mmiller7/Arduino-Velocity-Speed-Gun/Diagrams/Modification Schematic.pptx

Schematic

3.3V
Regulator

OUT

GND

Trigger Board

Battery+

Battery Ground

IN

470uF

CUT
TRACE

+5V USB Input

USB Ground

USB Data

10Ω

Trigger

V+ Out

10Ω

5V
Relay

5V Boost
Regulator

OUT

GND

IN

100uF

1kΩ

1kΩ

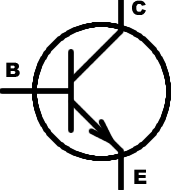
[picture p6: figure]

NPN

470uF

Arduino Micro
(or Leonardo, or ATmega32u4)

Radar Gun Control Board

5v

D7
(USB Pwr Detect)

D2
(Trigger)

GND

USB DATA

(Pwr On)
D3

(Pwr Off)
A11
D12

Trace

(LCD Data)
A0 - A10

LCD Pins

R1

## Slide 2

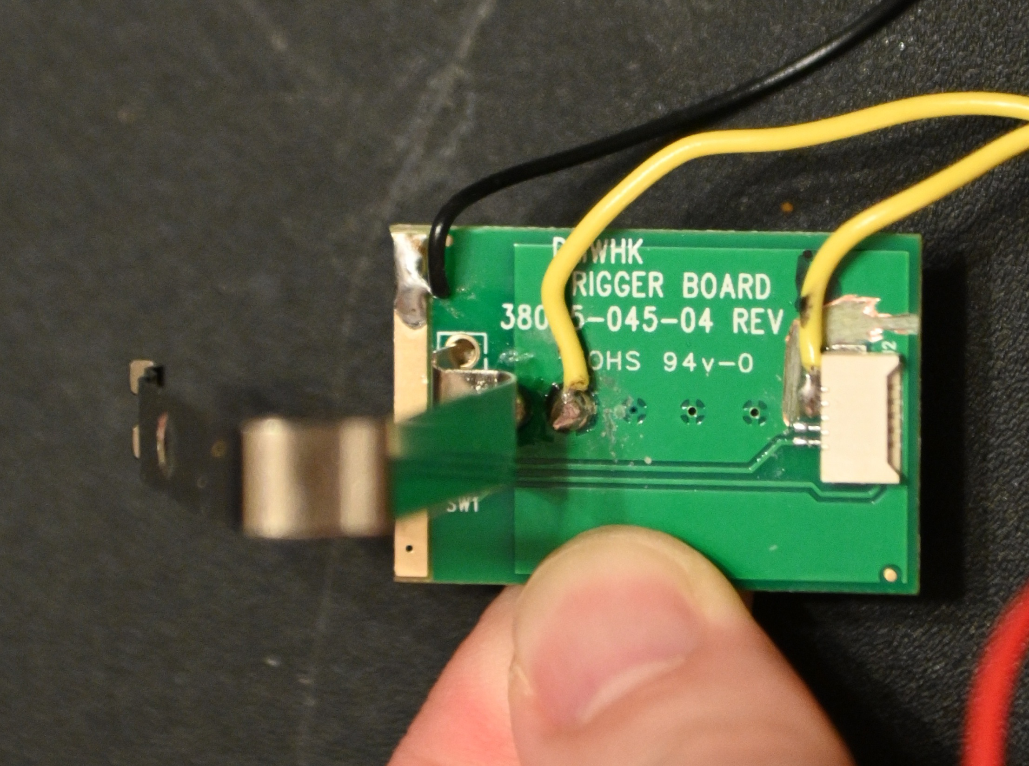
[picture p7: figure]

Trigger Board “Rev B” Modification Diagram

Trigger
Control

L-shaped
Cut Trace
separate
Battery +
from
board V+

Board
Positive

Top 3 Pins
all tied
together

Do Not Cut
bottom 2
traces

Battery
Positive

L-shaped
Cut Trace
separate
Battery +
from
board V+

## Slide 3

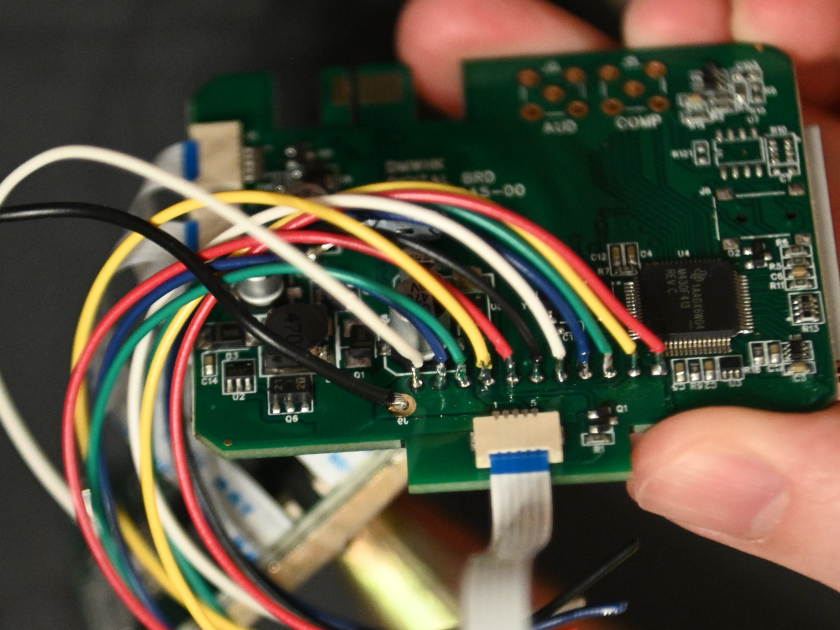
[picture p8: figure]

Main Board Modification Wiring

--A10
--A9
--A8
--A7
--A6
--A5
--A4
--A3
--A2
--A1
--A0

PWR
OFF

PWR
ON

## Slide 4

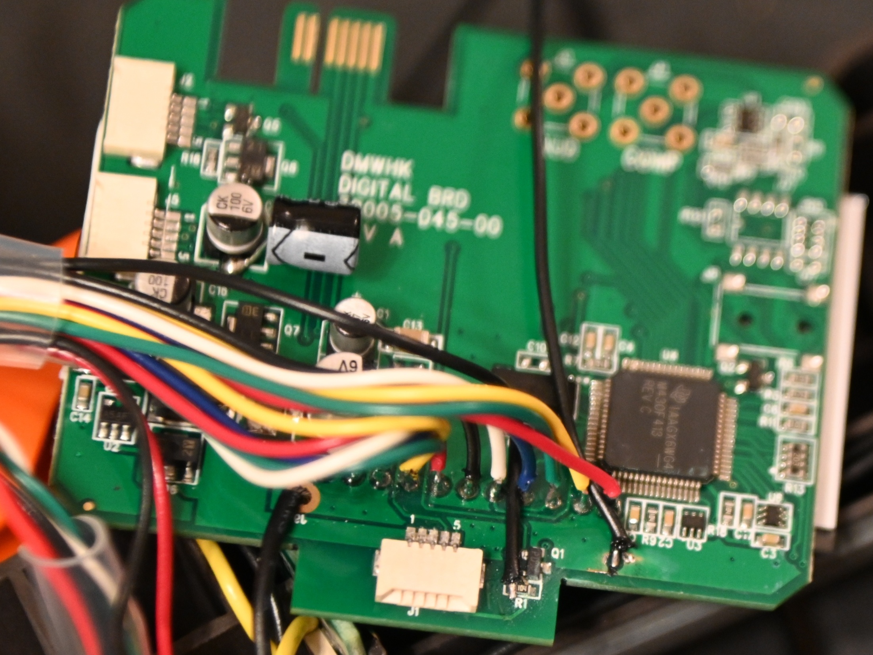
[picture p9: figure]

Main Board Modification Wiring

--A10
--A9
--A8
--A7
--A6
--A5
--A4
--A3
--A2
--A1
--A0

PWR ON

PWR
OFF

## Slide 5

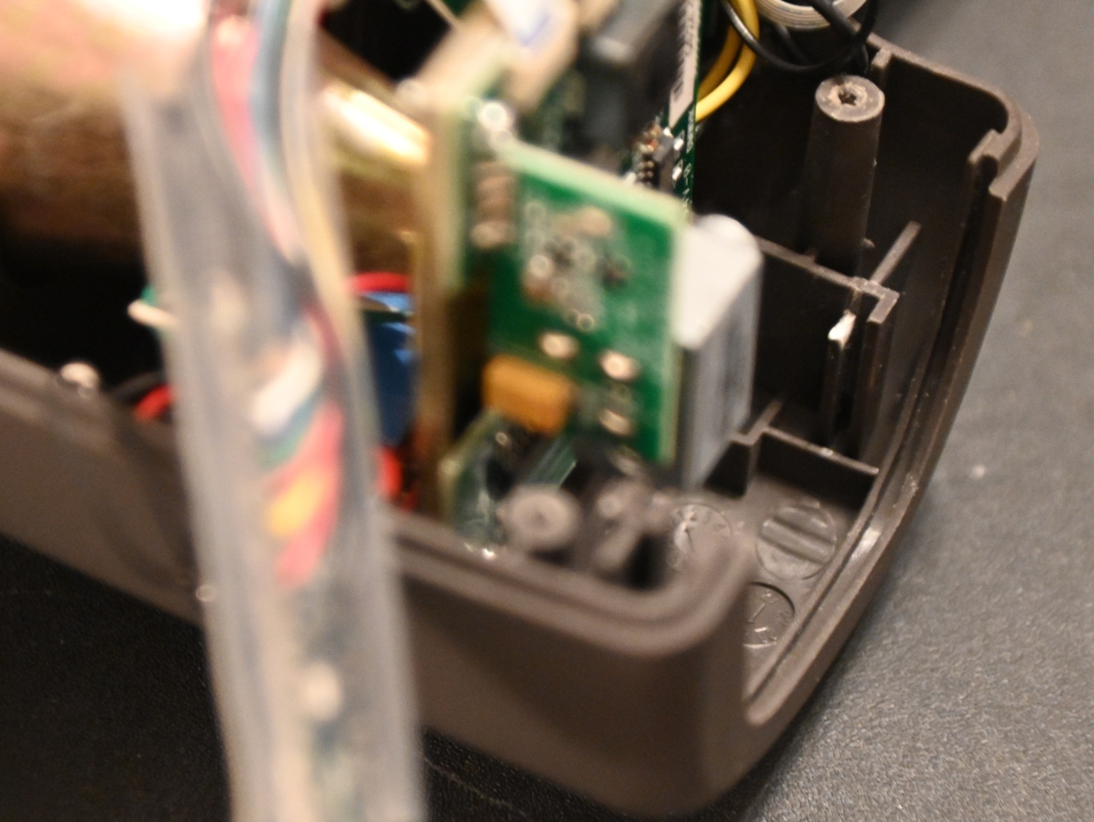
[picture p10: figure]

Case Modification

Cut/Remove
rear guide
1/4 to 3/8 inch
This portion of the
guide will damage
the trace for the
power-off wire
when board installed
