mmiller7/Arduino-Velocity-Speed-Gun/Photos/DSC_7530.JPG

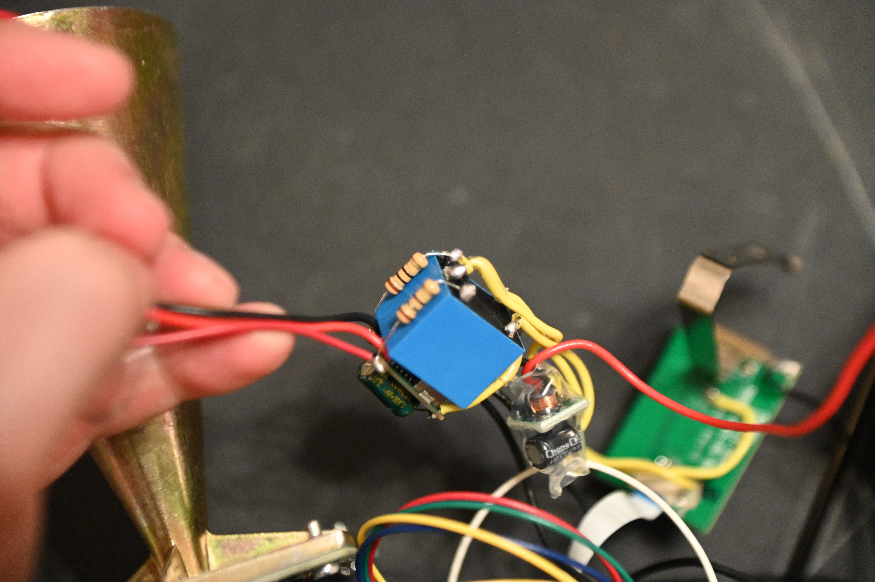
Photos/DSC_7530.JPG
