mmiller7/Arduino-Velocity-Speed-Gun/Photos/DSC_7531.JPG

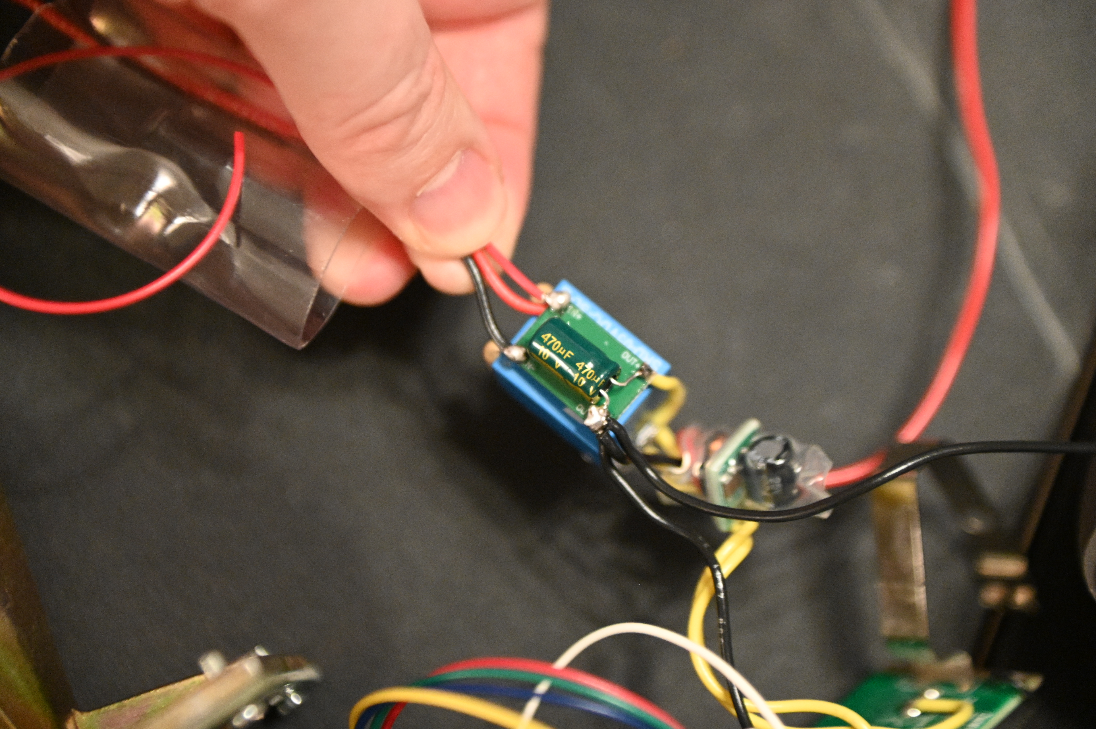
Photos/DSC_7531.JPG
