mmiller7/Arduino-Velocity-Speed-Gun/Photos/DSC_7532.JPG

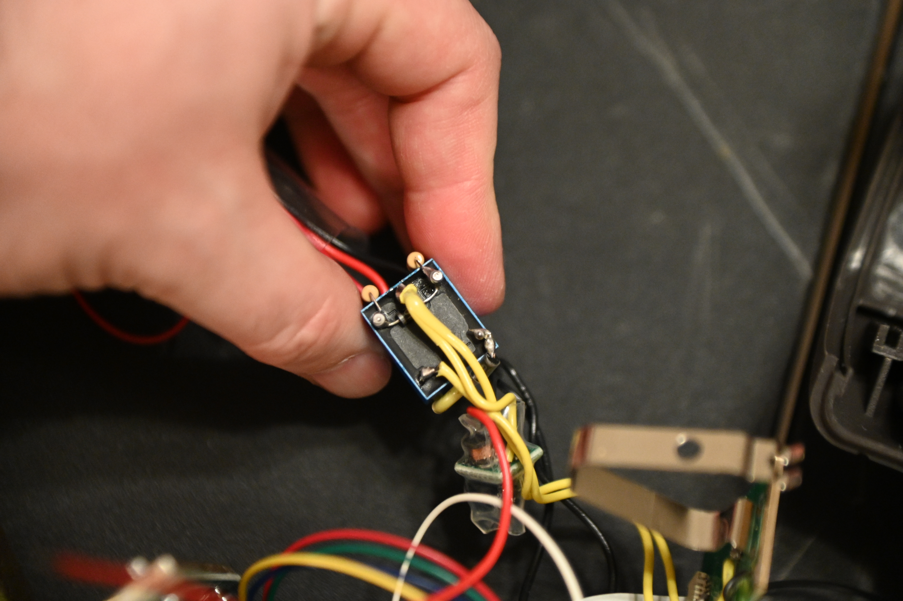
Photos/DSC_7532.JPG
