mmiller7/Arduino-Velocity-Speed-Gun/Photos/DSC_7533.JPG

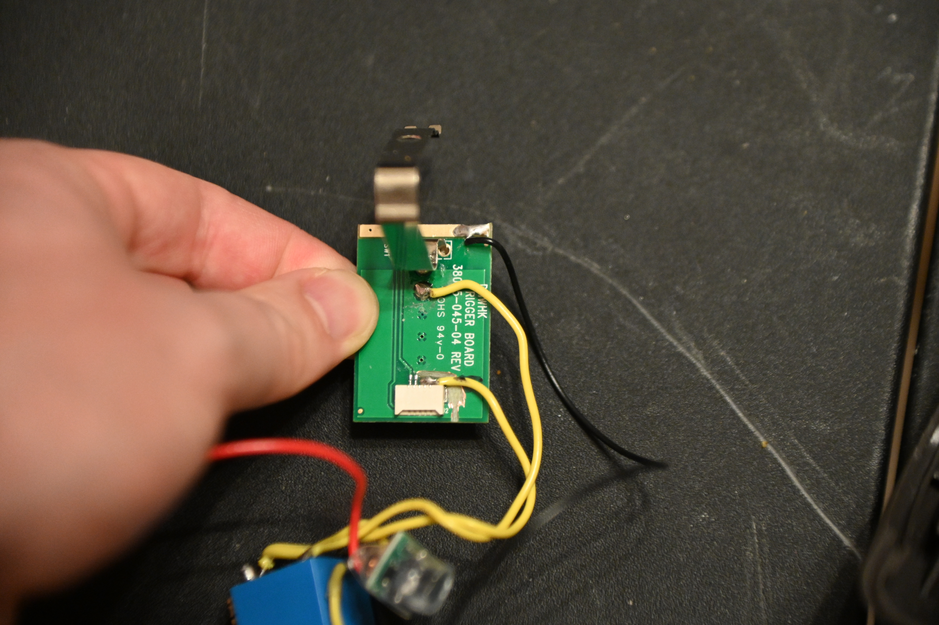
Photos/DSC_7533.JPG
