mmiller7/Arduino-Velocity-Speed-Gun/Photos/DSC_7534.JPG

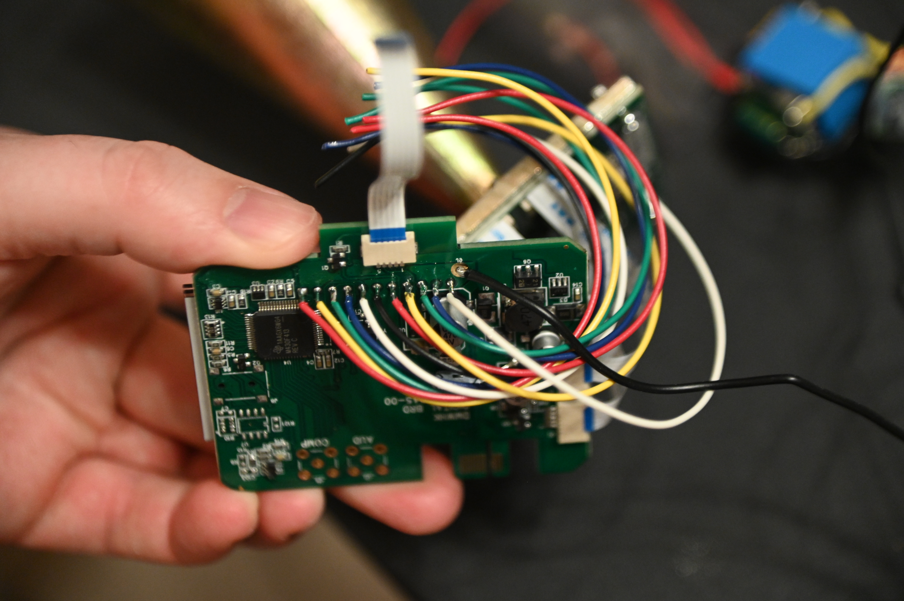
Photos/DSC_7534.JPG
