mmiller7/Arduino-Velocity-Speed-Gun/Photos/DSC_7535.JPG

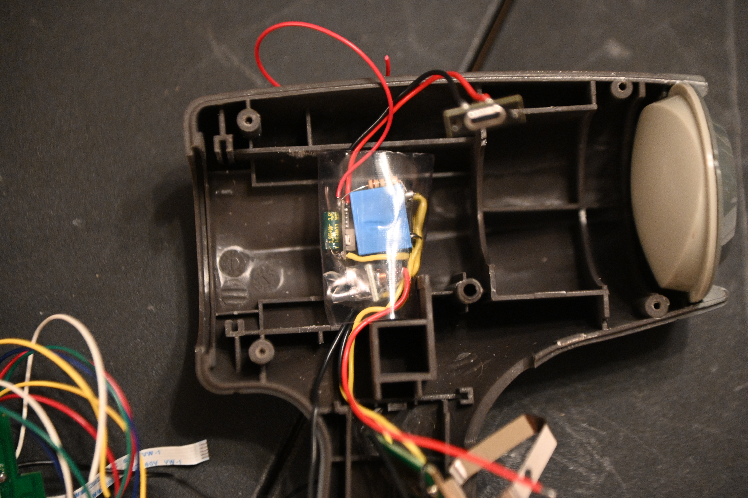
Photos/DSC_7535.JPG
