mmiller7/Arduino-Velocity-Speed-Gun/Photos/DSC_7537.JPG

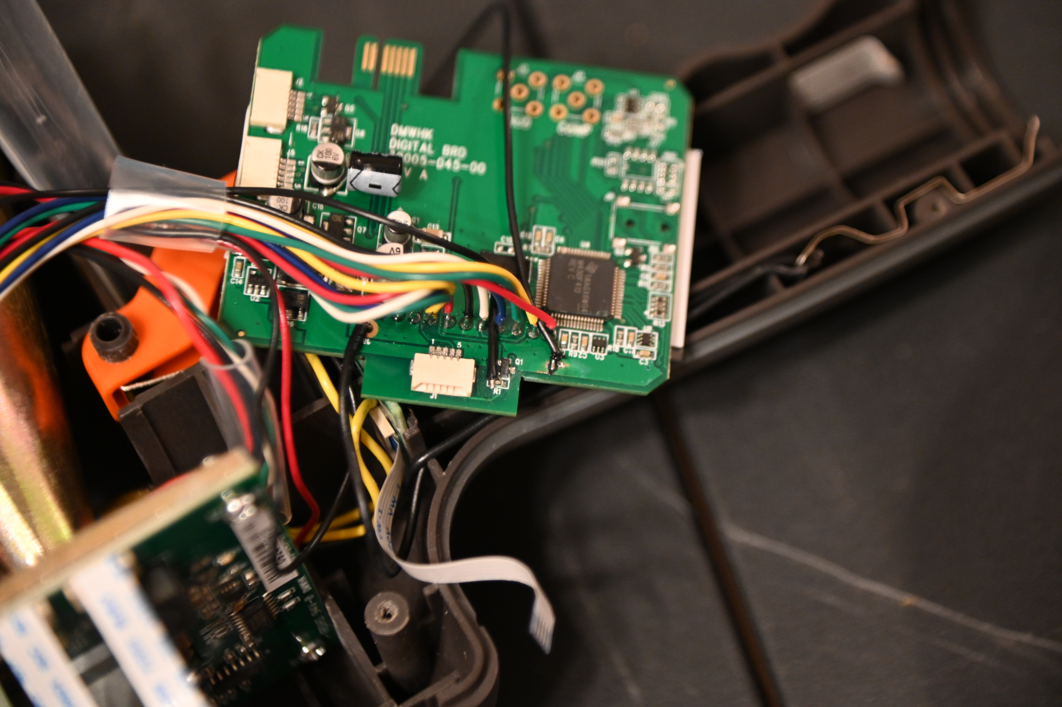
Photos/DSC_7537.JPG
