mmiller7/Arduino-Velocity-Speed-Gun/Photos/DSC_7538.JPG

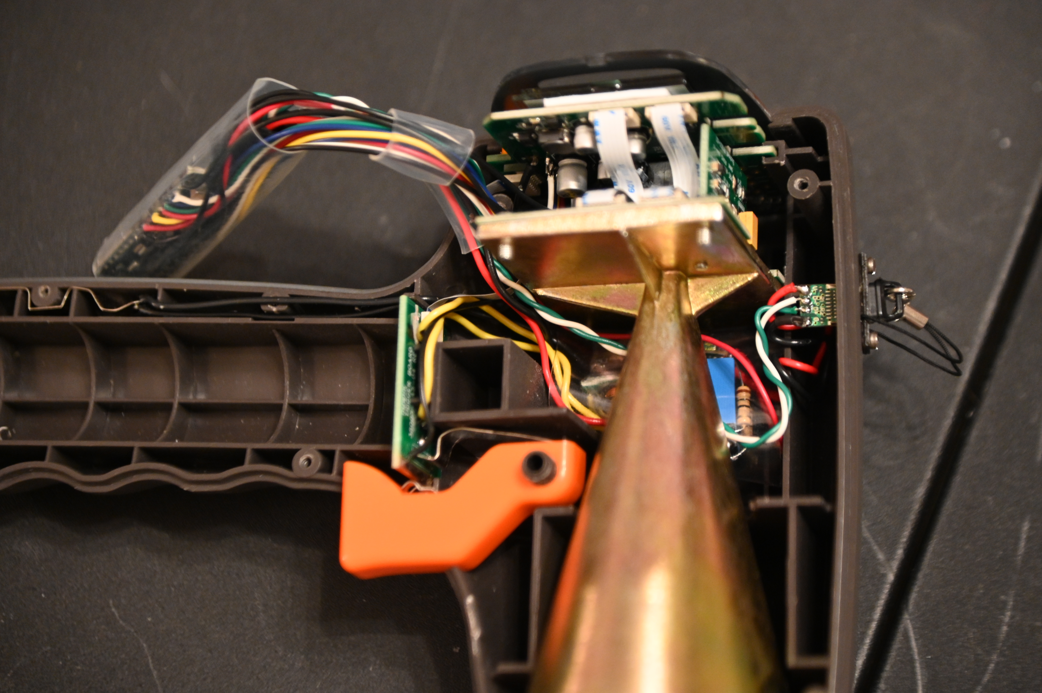
Photos/DSC_7538.JPG
