mmiller7/Arduino-Velocity-Speed-Gun/Photos/DSC_7539.JPG

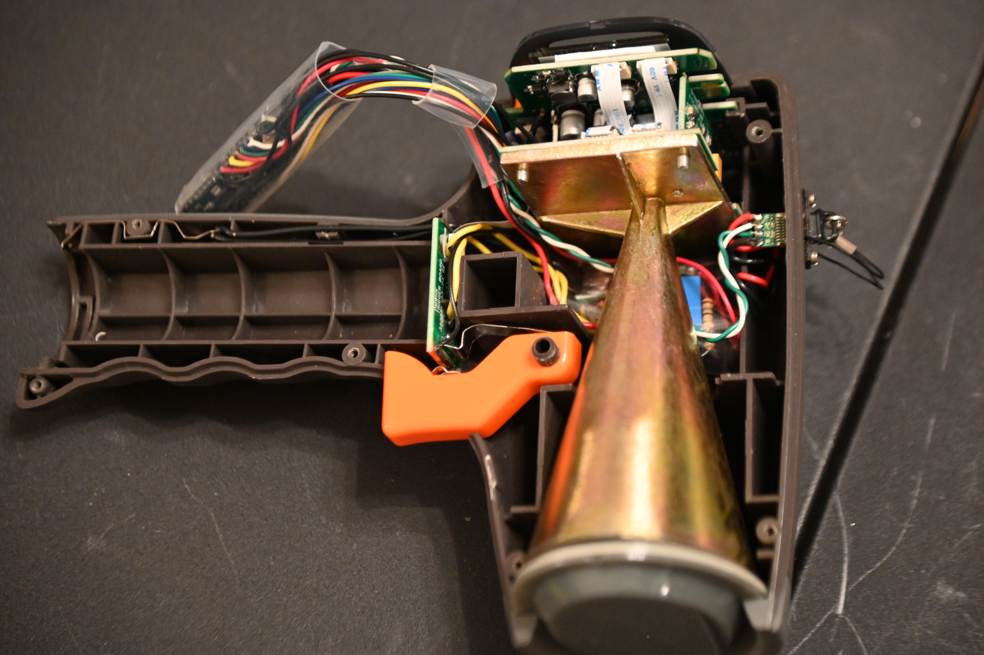
Photos/DSC_7539.JPG
