mmiller7/Arduino-Velocity-Speed-Gun/Photos/DSC_7540.JPG

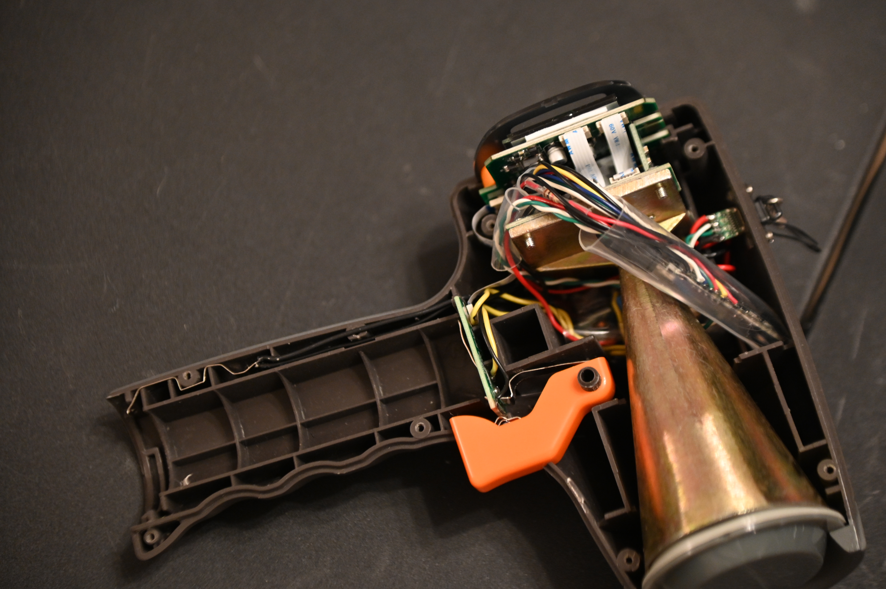
Photos/DSC_7540.JPG
