mmiller7/Arduino-Velocity-Speed-Gun/Photos/DSC_7541.JPG

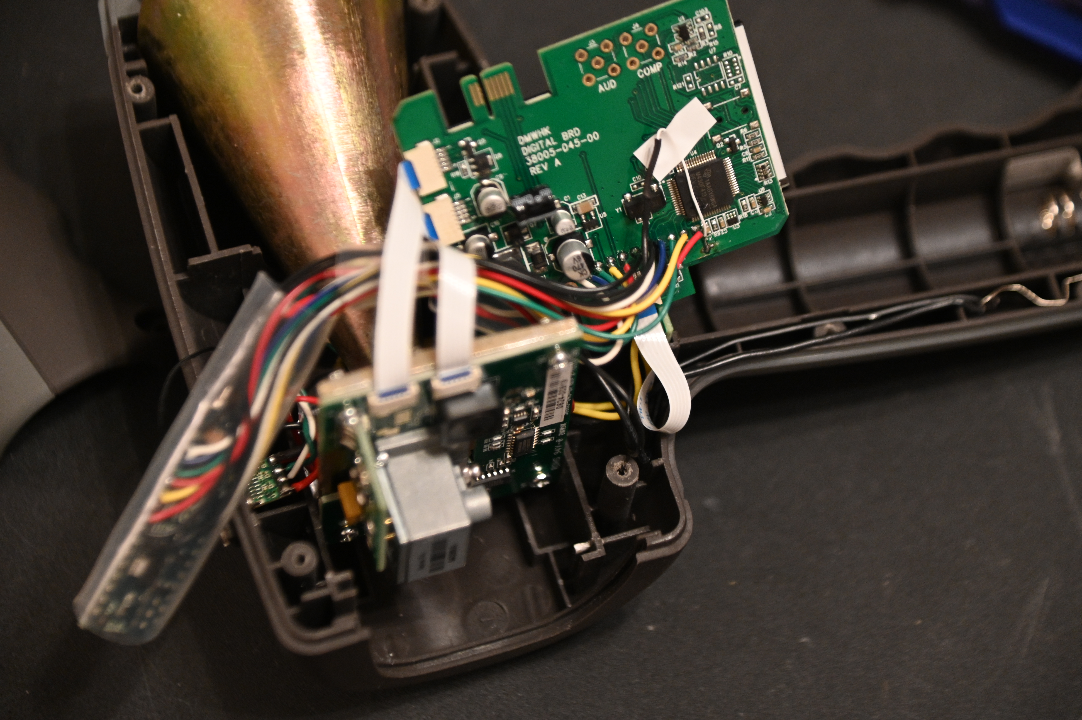
Photos/DSC_7541.JPG
