mmiller7/Arduino-Velocity-Speed-Gun/Photos/DSC_7542.JPG

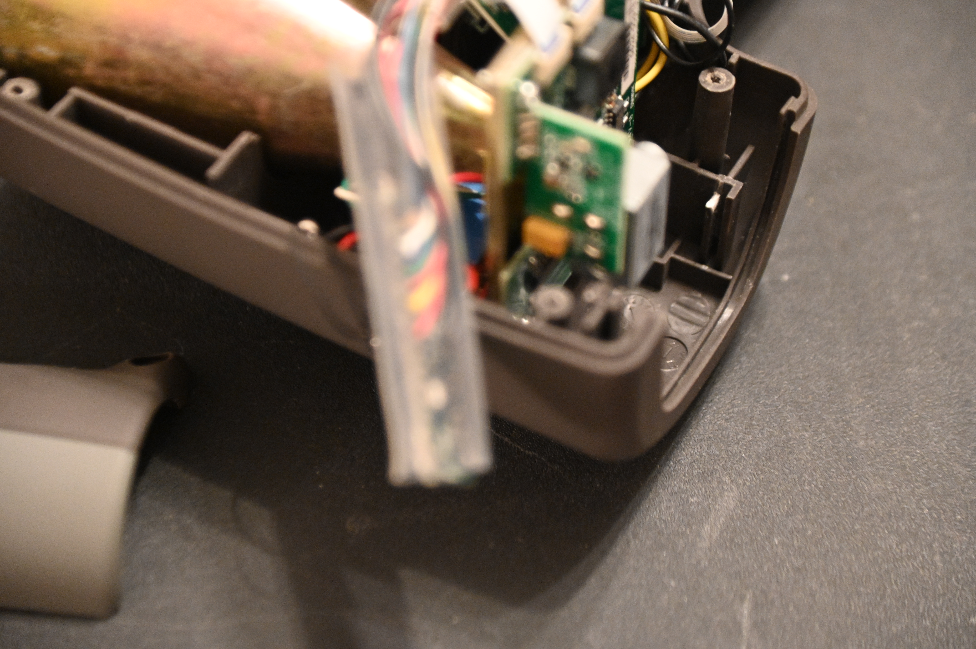
Photos/DSC_7542.JPG
