mmiller7/Arduino-Velocity-Speed-Gun/Photos/photo_2025-12-22_17-59-05.jpg

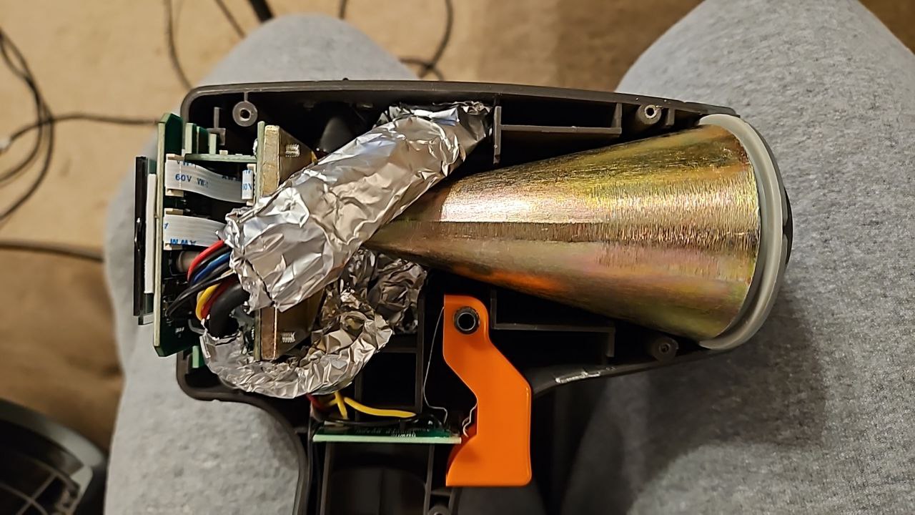
Photos/photo_2025-12-22_17-59-05.jpg
