mmiller7/Arduino-Velocity-Speed-Gun/Scope Readings/A0.png

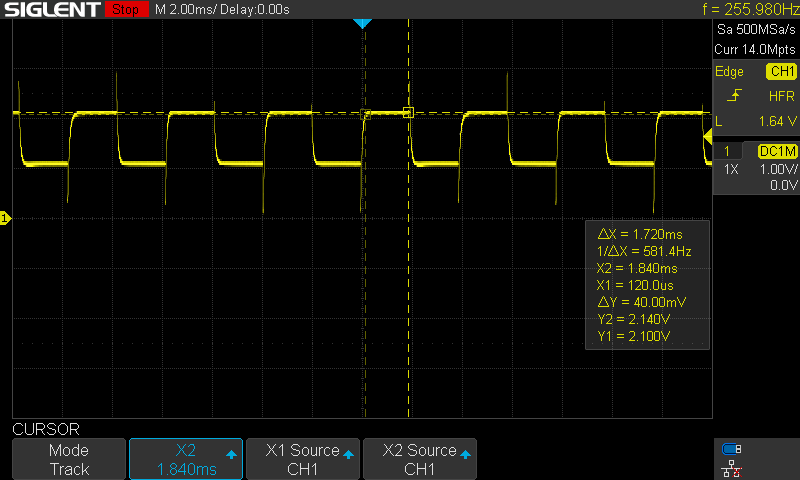
Scope Readings/A0.png
