mmiller7/Arduino-Velocity-Speed-Gun/Scope Readings/A2.png

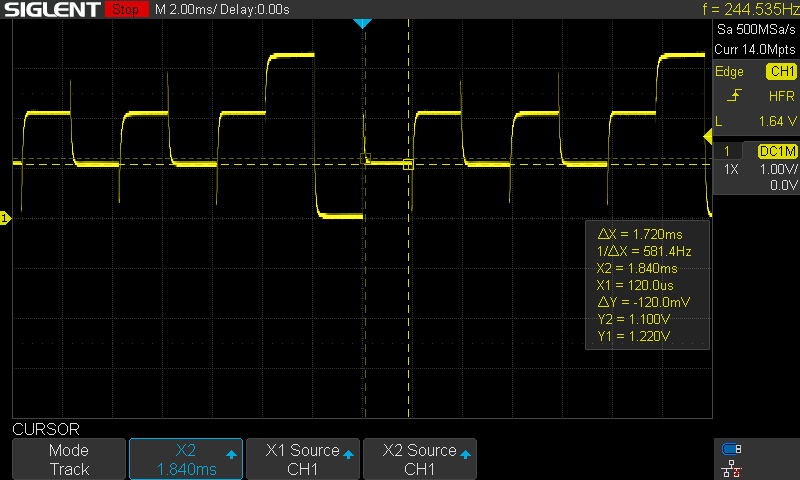
Scope Readings/A2.png
