mmiller7/Arduino-Velocity-Speed-Gun/Scope Readings/A4.png

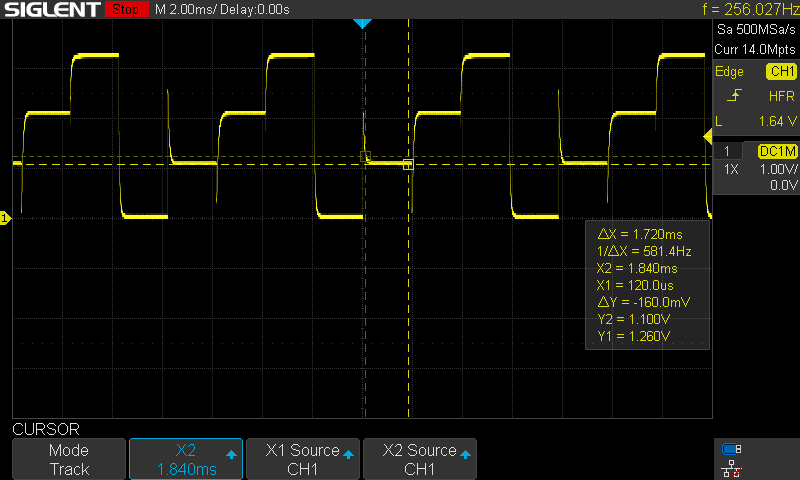
Scope Readings/A4.png
