mmiller7/Arduino-Velocity-Speed-Gun/Scope Readings/A6.png

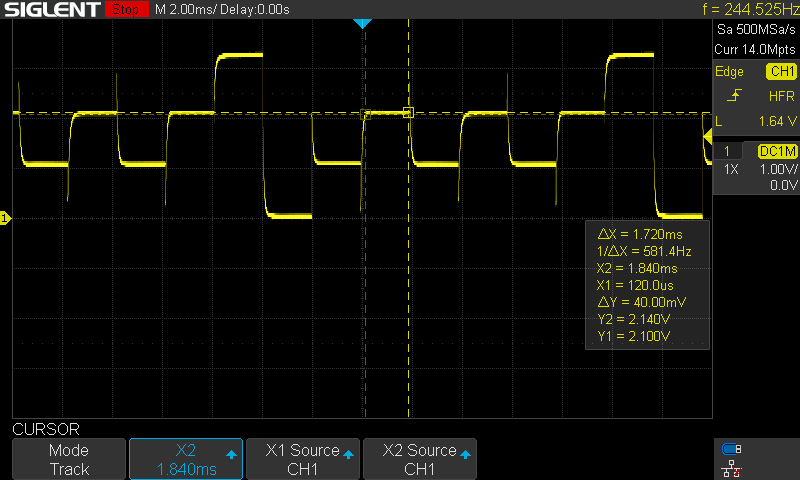
Scope Readings/A6.png
