mmiller7/Arduino-Velocity-Speed-Gun/Scope Readings/A7.png

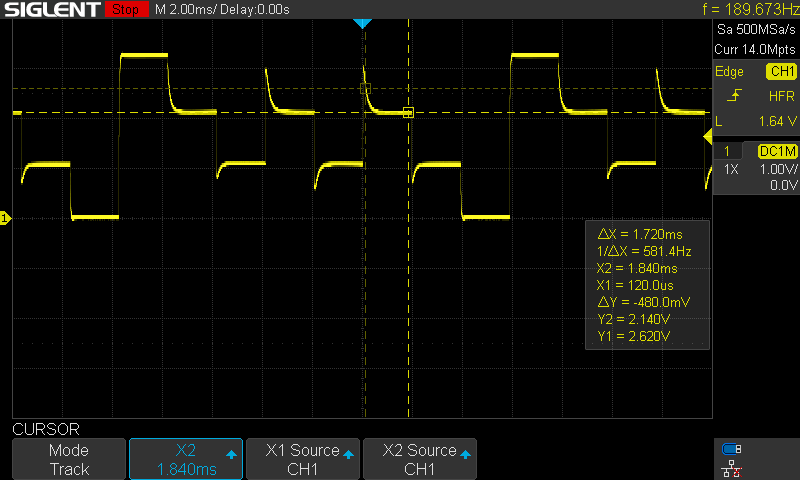
Scope Readings/A7.png
