mmiller7/Arduino-Velocity-Speed-Gun/Scope Readings/A8.png

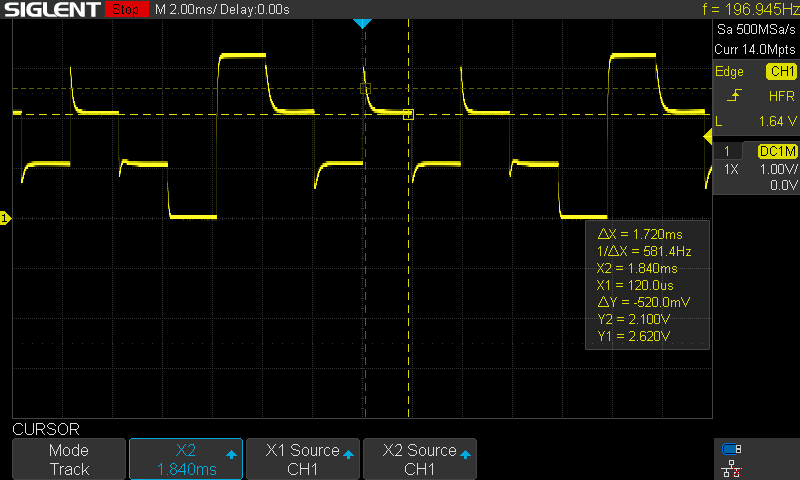
Scope Readings/A8.png
