mmiller7/Arduino-Velocity-Speed-Gun/Scope Readings/mph yellow-A2 purple-A9.png

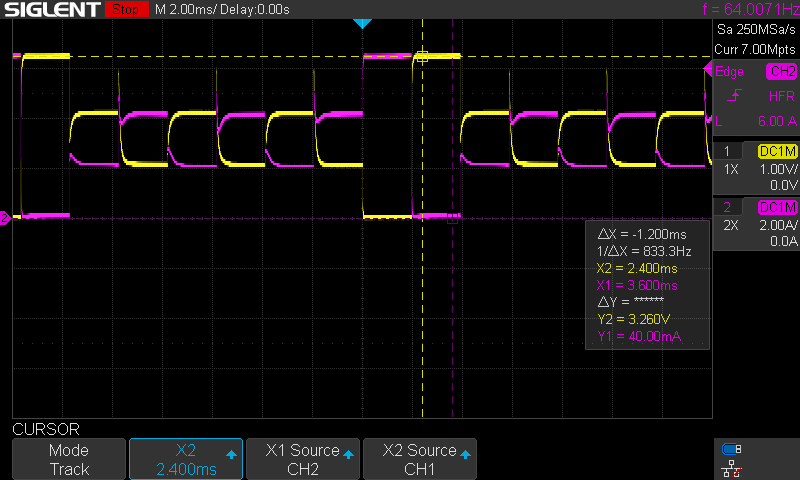
Scope Readings/mph yellow-A2 purple-A9.png
