mmiller7/Arduino-Velocity-Speed-Gun/Reference Material/Speed Angle Measurement Adjustments.xlsx

 | Measured Speed
Angle | 20 | 22.5 | 25 | 27.5 | 30 | 32.5 | 35 | 37.5 | 40 | 42.5 | 45 | 47.5 | 50 | 52.5 | 55
0 | 20.0 | 22.5 | 25.0 | 27.5 | 30.0 | 32.5 | 35.0 | 37.5 | 40.0 | 42.5 | 45.0 | 47.5 | 50.0 | 52.5 | 55.0
2.5 | 20.0 | 22.5 | 25.0 | 27.5 | 30.0 | 32.5 | 35.0 | 37.5 | 40.0 | 42.5 | 45.0 | 47.5 | 50.0 | 52.6 | 55.1
5 | 20.1 | 22.6 | 25.1 | 27.6 | 30.1 | 32.6 | 35.1 | 37.6 | 40.2 | 42.7 | 45.2 | 47.7 | 50.2 | 52.7 | 55.2
7.5 | 20.2 | 22.7 | 25.2 | 27.7 | 30.3 | 32.8 | 35.3 | 37.8 | 40.3 | 42.9 | 45.4 | 47.9 | 50.4 | 53.0 | 55.5
10 | 20.3 | 22.8 | 25.4 | 27.9 | 30.5 | 33.0 | 35.5 | 38.1 | 40.6 | 43.2 | 45.7 | 48.2 | 50.8 | 53.3 | 55.8
12.5 | 20.5 | 23.0 | 25.6 | 28.2 | 30.7 | 33.3 | 35.8 | 38.4 | 41.0 | 43.5 | 46.1 | 48.7 | 51.2 | 53.8 | 56.3
15 | 20.7 | 23.3 | 25.9 | 28.5 | 31.1 | 33.6 | 36.2 | 38.8 | 41.4 | 44.0 | 46.6 | 49.2 | 51.8 | 54.4 | 56.9
17.5 | 21.0 | 23.6 | 26.2 | 28.8 | 31.5 | 34.1 | 36.7 | 39.3 | 41.9 | 44.6 | 47.2 | 49.8 | 52.4 | 55.0 | 57.7
20 | 21.3 | 23.9 | 26.6 | 29.3 | 31.9 | 34.6 | 37.2 | 39.9 | 42.6 | 45.2 | 47.9 | 50.5 | 53.2 | 55.9 | 58.5
22.5 | 21.6 | 24.4 | 27.1 | 29.8 | 32.5 | 35.2 | 37.9 | 40.6 | 43.3 | 46.0 | 48.7 | 51.4 | 54.1 | 56.8 | 59.5
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
