mmiller7/Arduino-Velocity-Speed-Gun/(commit log)

2026-01-08 adding scripts
    [speedgun_to_tsv_example_output.tsv]
2026-01-15 Added +/- sign to verified speed % to help indicate which direction the error is believed to be Adjusted defaults for verifying speed
    [radar_gun_matt.ino]
2026-01-23 Added check to attempt recovery during power-on failure loop Improved power-on self-diagnostics and warnings Adjusted LCD scan to reduce chances of validation errors
    [radar_gun_matt.ino]
2026-01-24 v8 Fixed error in debug preprocessor directives Added delay option before verification-reading scans Enhanced verify-reading to allow multiple verification scans, identifying worst % error Re-ordered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
    [radar_gun_matt.ino]
2026-01-24 Fixed alignment of print statments for readability
    [radar_gun_matt.ino]
2026-02-02 fixed typo in comments
    [radar_gun_matt.ino]
2026-05-04 Added optional function to de-duplicate records based on timestamp
