mmiller7/Arduino-Velocity-Speed-Gun/Photos/DSC_7536.JPG

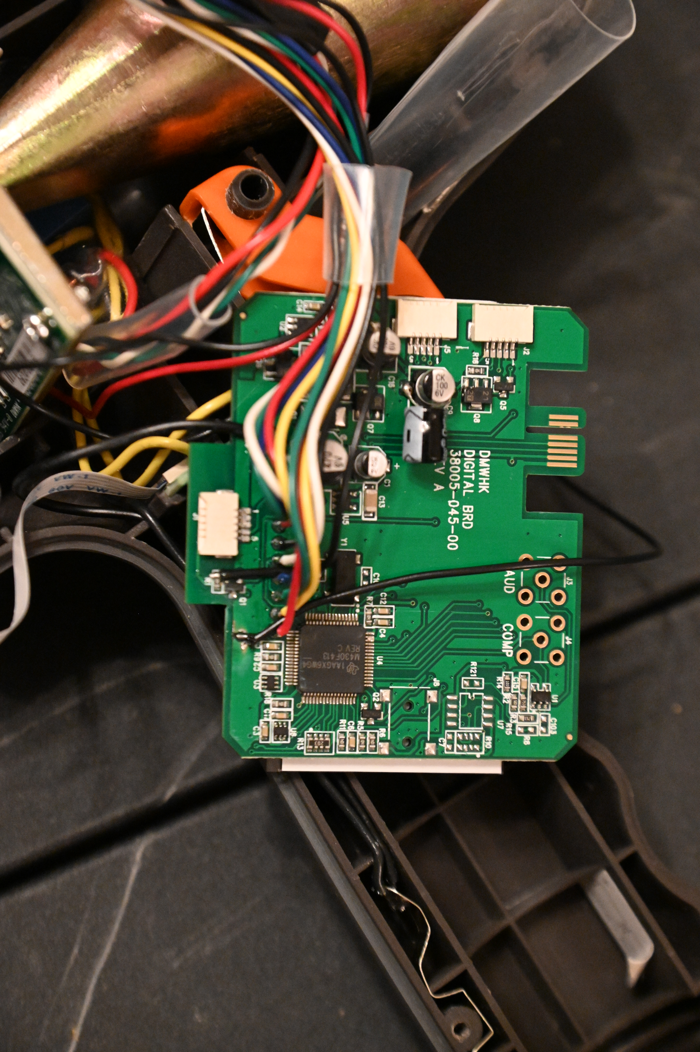
Photos/DSC_7536.JPG
